MostafaHashemifard/Connected-car-dongle/README.md

# Connected-car-dongle
A device that is used to make cars connected to the cloud
