MostafaHashemifard/Connected-car-dongle/Documentation/SIM868/SIM868-raspberry-pi-schematic.pdf

5V C7 U2 | L1 5V U1 R5 R6 R7 22uF/6.3V 1K 5.6K 3.6K Power | MICP MICN C3 C4 C5 C6 GND C13 C14 1 1 SPK1N 10P 30P 2 10P 30P GND earphone

# USB to UART

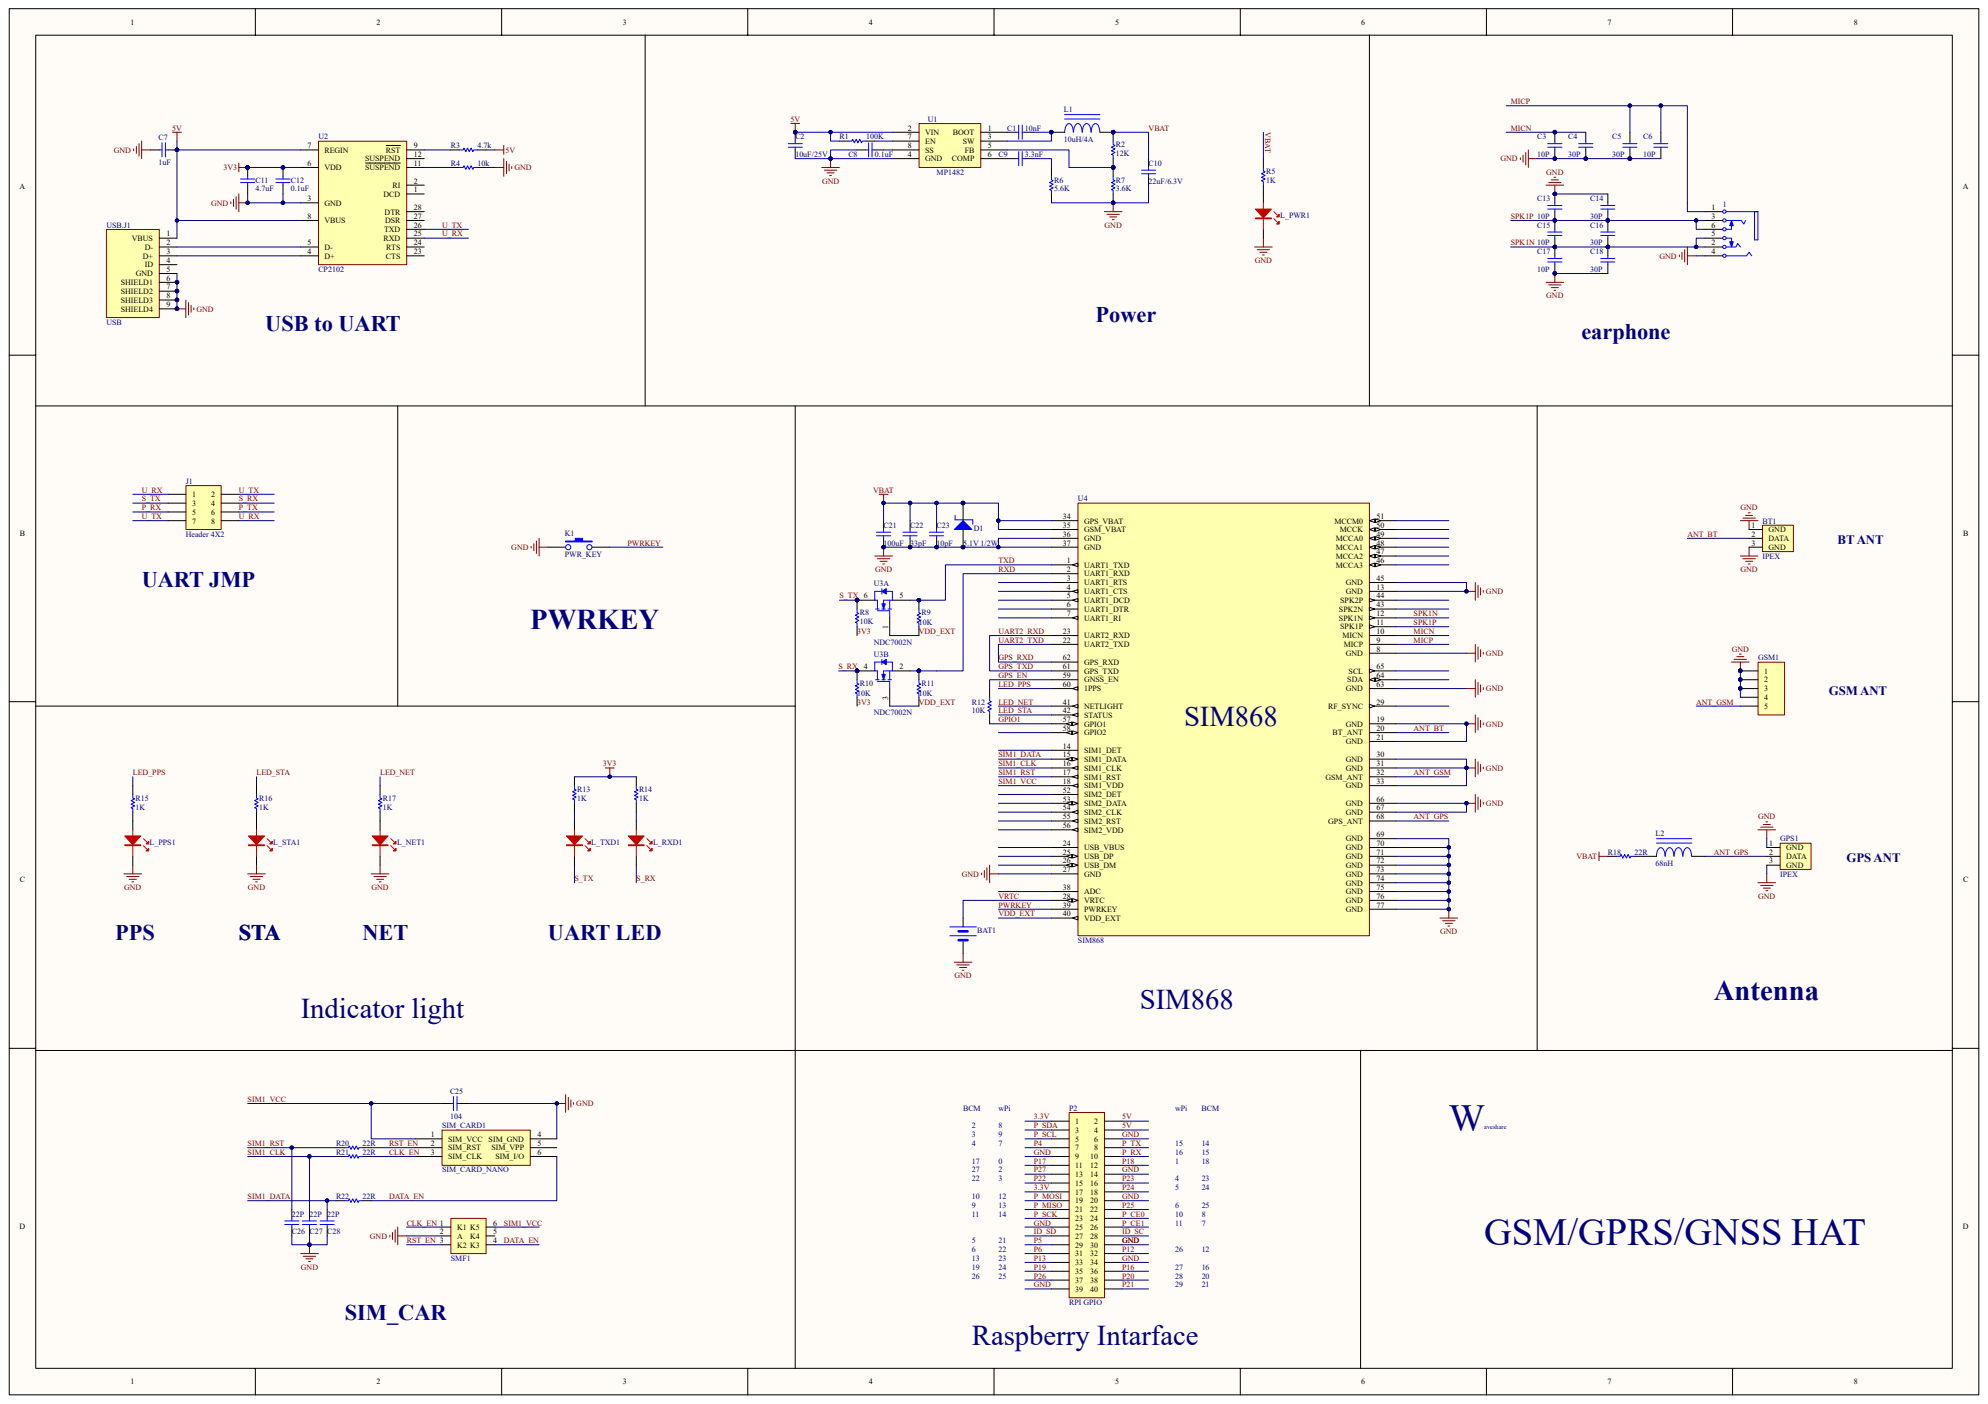
[picture p2: page 1]

GSM/GPRS/GNSS HAT
