MostafaHashemifard/Connected-car-dongle/Documentation/SIM868/Pico-SIM868-GSM-GPRS-GNSS-Schematic.pdf

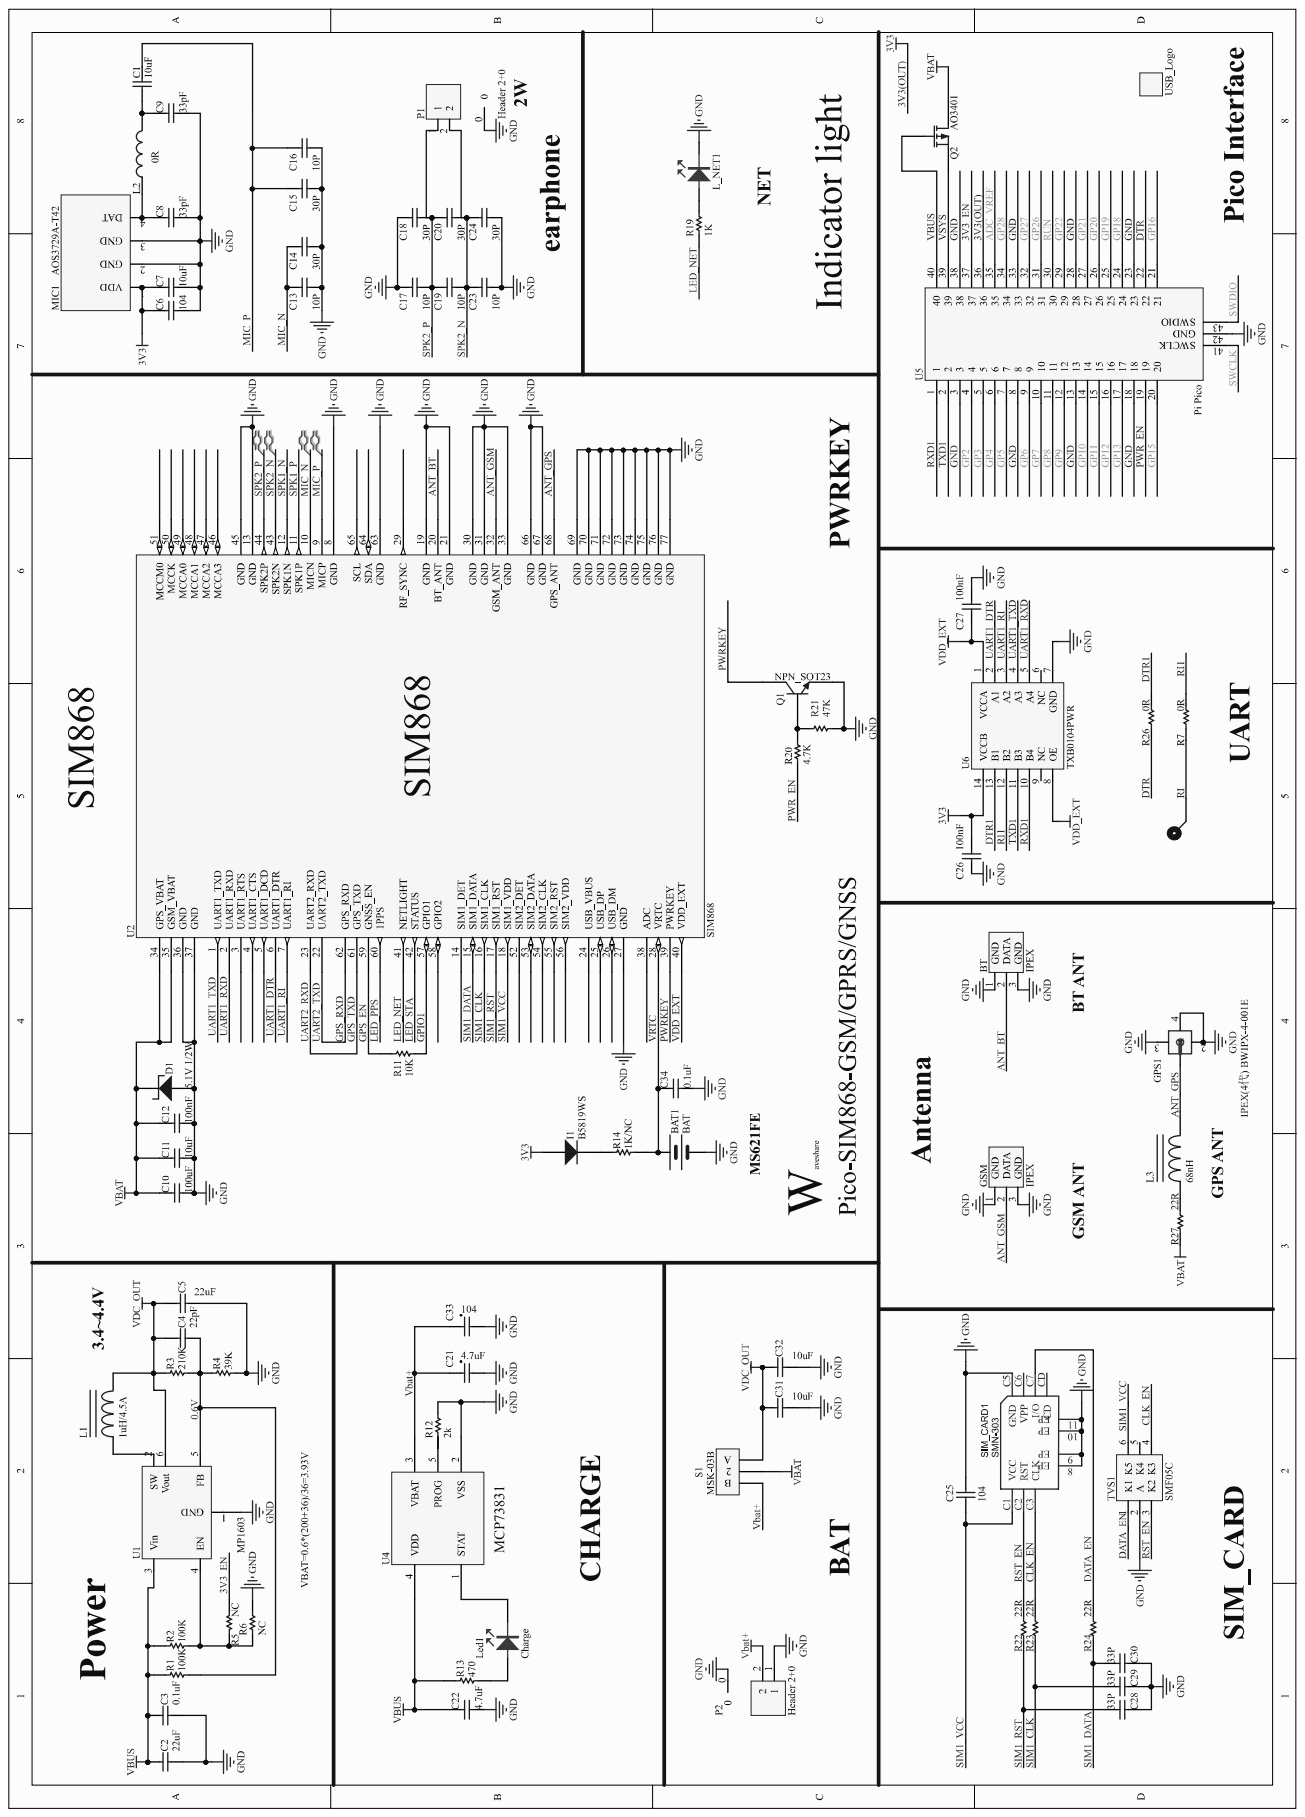
[picture p3: page 1]
