MostafaHashemifard/Connected-car-dongle/Hardware-ng/SIM868-ng/SIM868-ng.brd

## EAGLE design Hardware-ng/SIM868-ng/SIM868-ng.brd (2024-04-21)

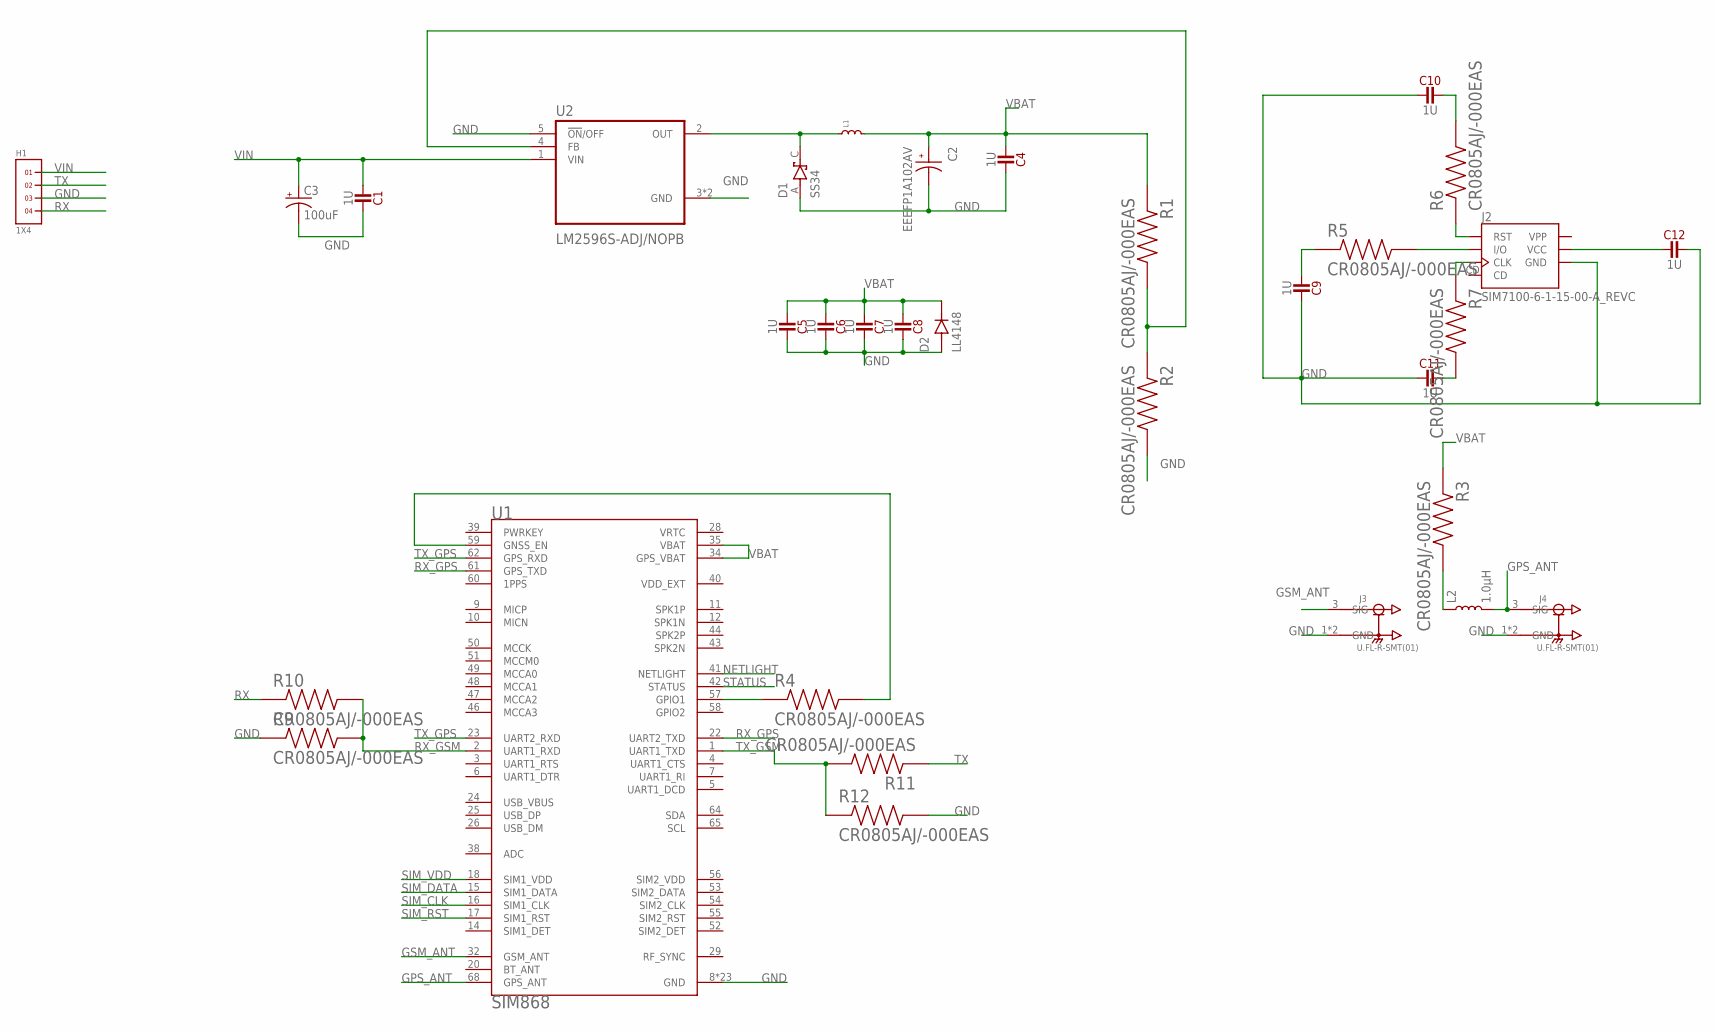
[picture p4: schematic SIM868-ng.sch]

Parts:
C1, C4, C5, C6, C7, C8, C9, C10, C11, C12: 1U; C-0805
C2: EEEFP1A102AV; CAP_EEEFP1A102AV
C3: 100uF; EIA3528
D1: SS34; DIOM7959X265N
D2: LL4148; DIO_LL4148
H1: 1X4
J2: SIM7100-6-1-15-00-A_REVC; GCT_SIM7100-6-1-15-00-A_REVC
J3, J4: U.FL-R-SMT(01); HRS_U.FL-R-SMT(01)
L1: INDUCTOR.XAL1010; XAL1010
L2: 1.0μH; 0805-WIDE
R1, R2, R3, R4, R5, R6, R7, R9, R10, R11, R12: CR0805AJ/-000EAS; RESC2012X60N
U1: SIM868; XCVR_SIM868
U2: LM2596S-ADJ/NOPB; VREG_LM2596S-ADJ/NOPB

Connections:
GND: C1.2, C2.2, C3.C (-), C4.2, C5.2, C6.2, C7.2, C8.2, C9.2, C10.1, C11.1, C12.2, D1.A, D2.A, H1.3, J2.C5 (GND), J3.1 (GND), J3.2 (GND), J4.1 (GND), J4.2 (GND), R2.2, R9.1, R12.2, U1.8 (GND), U1.13 (GND), U1.19 (GND), U1.21 (GND), U1.27 (GND), U1.30 (GND), U1.31 (GND), U1.33 (GND), U1.36 (GND), U1.37 (GND), U1.45 (GND), U1.63 (GND), U1.66 (GND), U1.67 (GND), U1.69 (GND), U1.70 (GND), U1.71 (GND), U1.72 (GND), U1.73 (GND), U1.74 (GND), U1.75 (GND), U1.76 (GND), U1.77 (GND), U2.3 (GND), U2.5 (!ON!/OFF), U2.6 (GND)
GPS_ANT: J4.3 (SIG), L2.2, U1.68 (GPS_ANT)
GSM_ANT: J3.3 (SIG), U1.32 (GSM_ANT)
unnamed: D1.C (K), L1.P$1 (1), U2.2 (OUT)
unnamed: R4.1, U1.57 (GPIO1)
unnamed: R1.2, R2.1, U2.4 (FB)
unnamed: L2.1, R3.2
unnamed: R4.2, U1.59 (GNSS_EN)
unnamed: J2.C7 (I/O), R5.2
unnamed: C9.1, R5.1
unnamed: J2.C2 (RST), R6.1
unnamed: C10.2, R6.2
unnamed: C11.2, R7.2
unnamed: J2.C3 (CLK), R7.1
unnamed: C12.1, J2.C1 (VCC)
NETLIGHT: U1.41 (NETLIGHT)
RX: H1.4, R10.1
RX_GPS: U1.22 (UART2_TXD), U1.61 (GPS_TXD)
RX_GSM: R9.2, R10.2, U1.2 (UART1_RXD)
SIM_CLK: U1.16 (SIM1_CLK)
SIM_DATA: U1.15 (SIM1_DATA)
SIM_RST: U1.17 (SIM1_RST)
SIM_VDD: U1.18 (SIM1_VDD)
STATUS: U1.42 (STATUS)
TX: H1.2, R11.1
TX_GPS: U1.23 (UART2_RXD), U1.62 (GPS_RXD)
TX_GSM: R11.2, R12.1, U1.1 (UART1_TXD)
VBAT: C2.1, C4.1, C5.1, C6.1, C7.1, C8.1, D2.C, L1.P$2 (2), R1.1, R3.1, U1.34 (GPS_VBAT), U1.35 (VBAT)
VIN: C1.1, C3.A (+), H1.1, U2.1 (VIN)
VPP: J2.C6 (VPP)
VRTC: U1.28 (VRTC)

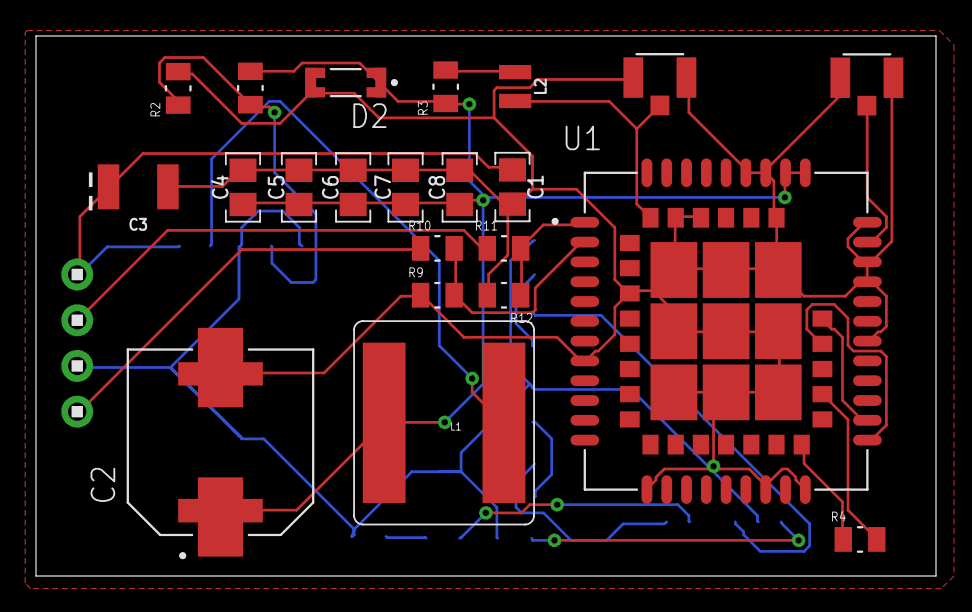
[picture p5: board SIM868-ng.brd from above]

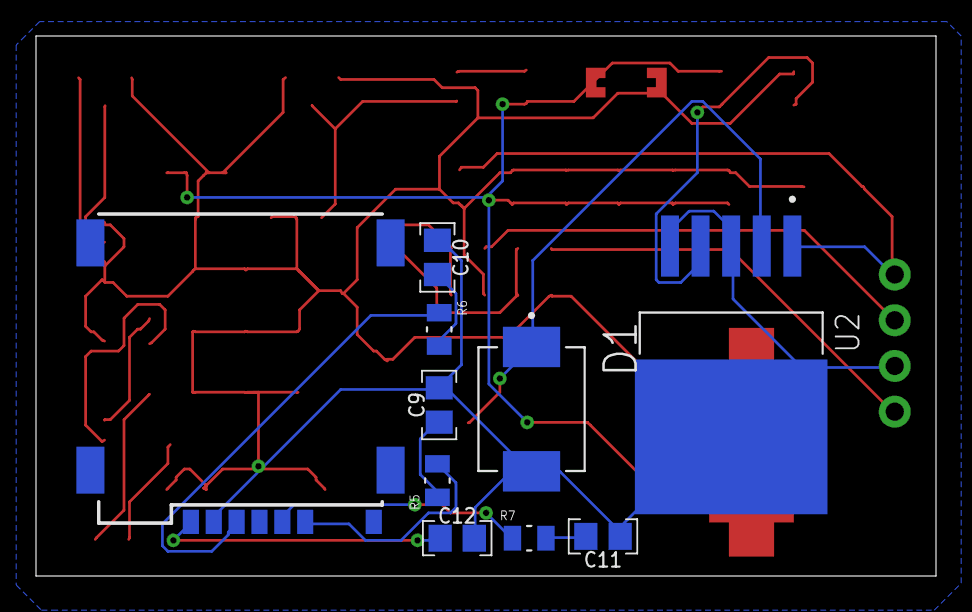
[picture p6: board SIM868-ng.brd from below]

Board: 2 copper layers, 50.0 x 30.0 mm, 33 parts (10 on the bottom side), 23 nets.
