MostafaHashemifard/Connected-car-dongle/Hardware/ESP32/ESP32.brd

## EAGLE design Hardware/ESP32/ESP32.brd (2024-04-21)

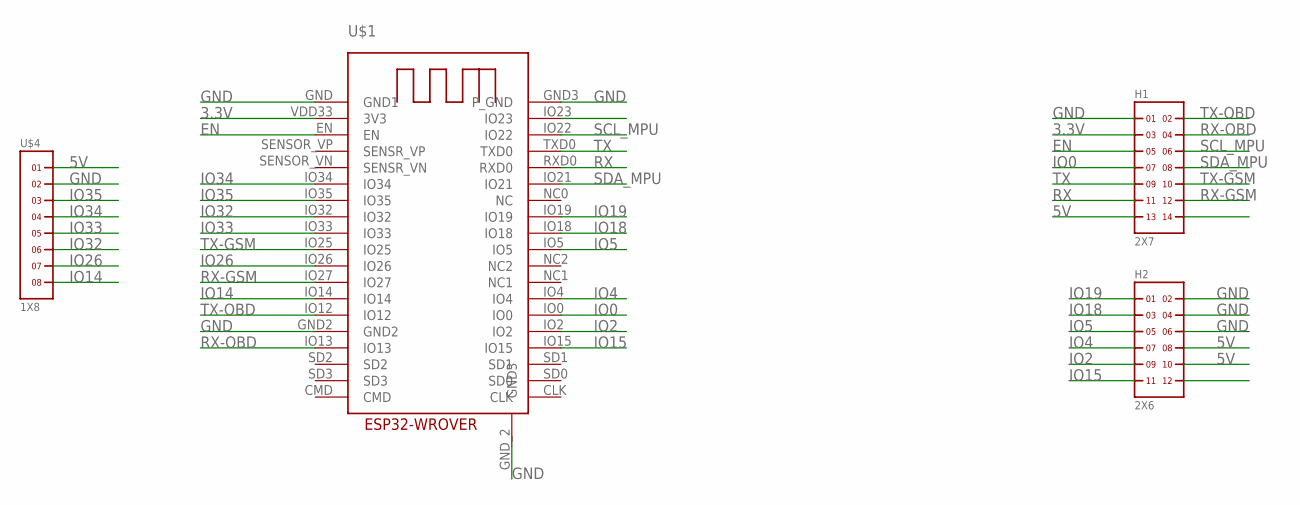
[picture p7: schematic ESP32.sch]

Parts:
H1: 2X7
H2: 2X6
U$1: ESP32-WROVER
U$4: 1X8

Connections:
3.3V: H1.3, U$1.VDD33 (3V3)
5V: H1.13, H2.8, H2.10, U$4.1
EN: H1.5, U$1.EN
GND: H1.1, H2.2, H2.4, H2.6, U$1.GND (GND1), U$1.GND2, U$1.GND3 (P_GND), U$1.GND_2 (GND3), U$4.2
IO0: H1.7, U$1.IO0
IO2: H2.9, U$1.IO2
IO4: H2.7, U$1.IO4
IO5: H2.5, U$1.IO5
IO14: U$1.IO14, U$4.8
IO15: H2.11, U$1.IO15
IO18: H2.3, U$1.IO18
IO19: H2.1, U$1.IO19
IO26: U$1.IO26, U$4.7
IO32: U$1.IO32, U$4.6
IO33: U$1.IO33, U$4.5
IO34: U$1.IO34, U$4.4
IO35: U$1.IO35, U$4.3
RX: H1.11, U$1.RXD0
RX-GSM: H1.12, U$1.IO27
RX-OBD: H1.4, U$1.IO13
SCL_MPU: H1.6, U$1.IO22
SDA_MPU: H1.8, U$1.IO21
TX: H1.9, U$1.TXD0
TX-GSM: H1.10, U$1.IO25
TX-OBD: H1.2, U$1.IO12

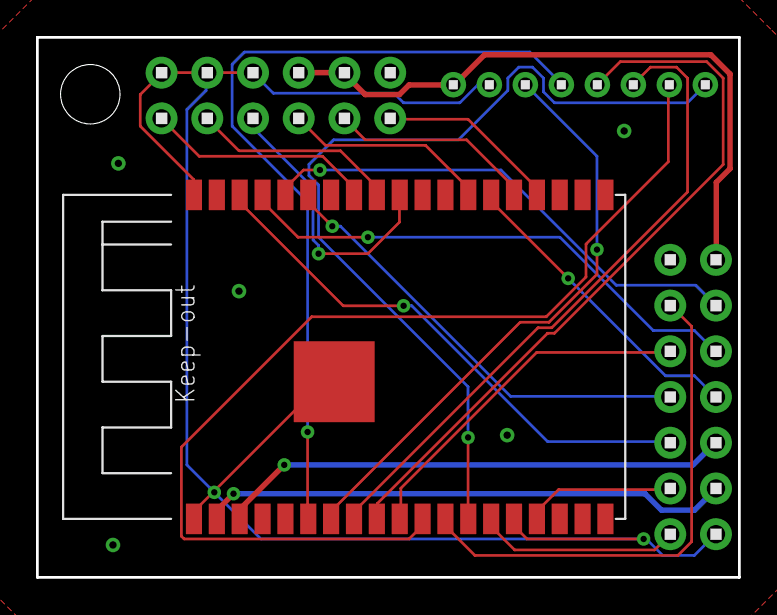
[picture p8: board ESP32.brd from above]

Board: 2 copper layers, 39.0 x 30.0 mm, 5 parts (0 on the bottom side), 25 nets.

Other parts of the board:
JP4: STAND-OFF
