MostafaHashemifard/Connected-car-dongle/Hardware-ng/ESP32-ng/ESP32-ng.brd

## EAGLE design Hardware-ng/ESP32-ng/ESP32-ng.brd (2024-04-21)

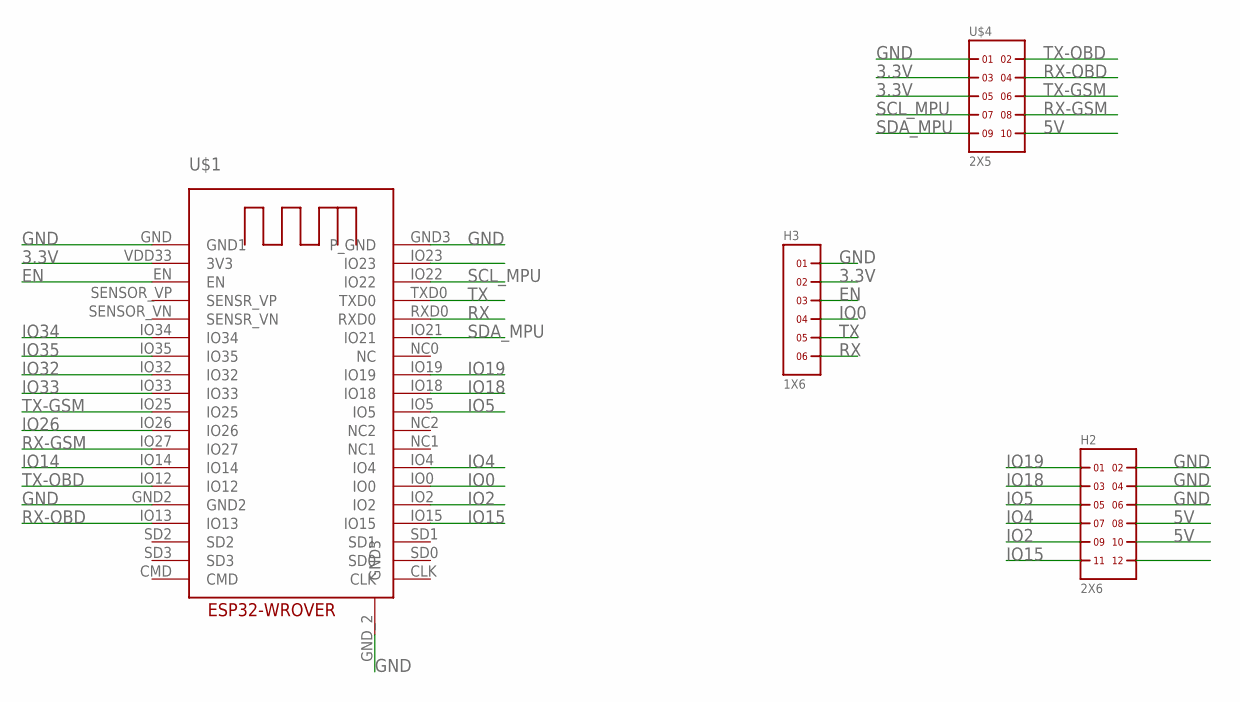
[picture p15: schematic ESP32-ng.sch]

Parts:
H2: 2X6
H3: 1X6
U$1: ESP32-WROVER
U$4: 2X5

Connections:
3.3V: H3.2, U$1.VDD33 (3V3), U$4.3, U$4.5
5V: H2.8, H2.10, U$4.10
EN: H3.3, U$1.EN
GND: H2.2, H2.4, H2.6, H3.1, U$1.GND (GND1), U$1.GND2, U$1.GND3 (P_GND), U$1.GND_2 (GND3), U$4.1
IO0: H3.4, U$1.IO0
IO2: H2.9, U$1.IO2
IO4: H2.7, U$1.IO4
IO5: H2.5, U$1.IO5
IO14: U$1.IO14
IO15: H2.11, U$1.IO15
IO18: H2.3, U$1.IO18
IO19: H2.1, U$1.IO19
IO26: U$1.IO26
IO32: U$1.IO32
IO33: U$1.IO33
IO34: U$1.IO34
IO35: U$1.IO35
RX: H3.6, U$1.RXD0
RX-GSM: U$1.IO27, U$4.8
RX-OBD: U$1.IO13, U$4.4
SCL_MPU: U$1.IO22, U$4.7
SDA_MPU: U$1.IO21, U$4.9
TX: H3.5, U$1.TXD0
TX-GSM: U$1.IO25, U$4.6
TX-OBD: U$1.IO12, U$4.2

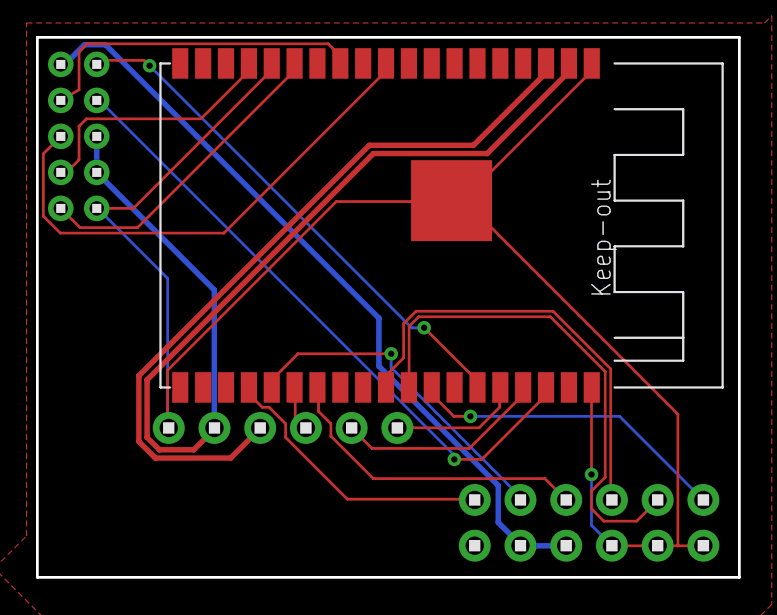
[picture p16: board ESP32-ng.brd from above]

Board: 2 copper layers, 39.0 x 30.0 mm, 4 parts (0 on the bottom side), 19 nets.
